lukmatuska/NeonPine/docs/compliance/04-eu-declaration-of-conformity.md

# EU Declaration of Conformity – DRAFT TEMPLATE

> **Do not sign until** the rev B hardware has passed EMC testing, the risk assessment is closed, and the RoHS evidence
> is complete. Fields in `[brackets]` are placeholders. Translate into the language(s) required by each member state of sale.

---

**EU DECLARATION OF CONFORMITY**  No. `[NP-DoC-001]`

1. **Product model / product:** NeonPine, decorative neon‑lamp Christmas tree, model `[NP‑1]`, hardware rev `[B]`,
   firmware `[x.y]`. Batch / serial range: `[from … to …]`.
2. **Name and address of the manufacturer** (and authorised representative, if any):
   `[Company name, street, postcode, city, country, e‑mail, web]`
   `[EU authorised representative / responsible economic operator under GPSR Art. 16: name, address]`
3. This declaration of conformity is issued under the sole responsibility of the manufacturer.
4. **Object of the declaration:** NeonPine model `[NP‑1]`, USB‑powered (5 V ⎓, ≤ 0.15 A) decorative light with ten neon glow
   lamps on a tree‑shaped printed circuit board. `[photo]`
5. The object of the declaration described above is in conformity with the relevant Union harmonisation legislation:
   * Directive **2014/30/EU** (electromagnetic compatibility)
   * Directive **2011/65/EU** and Commission Delegated Directive **(EU) 2015/863** (RoHS)
6. **References to the relevant harmonised standards used:**
   * EN IEC 55015:`[year+A]` *(or EN 55032:`[year]` Class B, according to the lab classification)*
   * EN 61547:`[year]` *(or EN 55035:`[year]`)*
   * EN IEC 63000:2018 (technical documentation for RoHS)
7. Notified body: **not applicable** (internal production control, Module A).
8. **Additional information:**
   * Product safety assessed under Regulation (EU) 2023/988 (GPSR) with reference to EN IEC 60598‑1, EN IEC 62368‑1
     (energy‑source method) and EN 62471. Risk assessment `[ref / rev]`.
   * Tested with power adapter `[make/model]` and a 1 m USB‑C cable.
   * WEEE producer registration numbers: `[DE: WEEE‑Reg.‑Nr. …, CZ: …, …]`

Signed for and on behalf of: `[Company]`
Place and date of issue: `[city, YYYY‑MM‑DD]`
Name, function: `[name, title]`  Signature: ____________________
