lukmatuska/NeonPine/docs/compliance/05-fcc-sdoc.md

# FCC Supplier's Declaration of Conformity – DRAFT

> 47 CFR §2.1077 compliance information. It must ship with the product (in the manual or as an insert) and the SDoC record
> must be kept by the **US‑based responsible party**. Fill in after the accredited lab report (Part 15 Subpart B, Class B) is issued.

## Compliance information statement (include in the user manual)

**Supplier's Declaration of Conformity**
47 CFR §2.1077 Compliance Information

**Unique identifier:** NeonPine, model `[NP‑1]`

**Responsible party – U.S. contact information:**
`[Company name]`
`[Street address, City, State ZIP, USA]`
`[Telephone number or internet contact]`

**FCC compliance statement (§15.19(a)(3)):**
This device complies with Part 15 of the FCC Rules. Operation is subject to the following two conditions:
(1) This device may not cause harmful interference, and (2) this device must accept any interference received, including
interference that may cause undesired operation.

**Information to the user (§15.105(b), Class B):**
NOTE: This equipment has been tested and found to comply with the limits for a Class B digital device, pursuant to Part 15
of the FCC Rules. These limits are designed to provide reasonable protection against harmful interference in a residential
installation. This equipment generates, uses and can radiate radio frequency energy and, if not installed and used in
accordance with the instructions, may cause harmful interference to radio communications. However, there is no guarantee
that interference will not occur in a particular installation. If this equipment does cause harmful interference to radio or
television reception, which can be determined by turning the equipment off and on, the user is encouraged to try to correct
the interference by one or more of the following measures:
* Reorient or relocate the receiving antenna.
* Increase the separation between the equipment and receiver.
* Connect the equipment into an outlet on a circuit different from that to which the receiver is connected.
* Consult the dealer or an experienced radio/TV technician for help.

**Modifications (§15.21):**
Changes or modifications not expressly approved by the party responsible for compliance could void the user's authority to
operate the equipment.

## Labelling (§15.19)
* The product is small, but the board has room for the short statement on the rear cover. If it doesn't fit legibly (≥ 4–6 pt),
  §15.19(a)(5) allows it to go in the user manual or on the packaging instead. **Recommended:** the full statement in the manual
  + packaging, plus model and responsible party name on the rear cover.
* The FCC logo is optional for SDoC devices.

## SDoC record to keep (not shipped)
* Lab test report (accredited lab), test setup photos, firmware version, adapter and cable used.
* Schematic, BOM, PCB rev and photos of the production unit.
* A statement that production units are identical to the tested sample, plus a change‑control note: re‑evaluate for any change to
  the boost converter, the MCU clock, the PCB layout or the USB connector.
