lukmatuska/NeonPine/docs/compliance/07-technical-file-index.md

# NeonPine – technical documentation (technical file) index

Keep for **10 years** after the last unit is placed on the EU market (EMC Directive Art. 7(3), GPSR Art. 9(2)). Must be
available to market surveillance authorities on request, in a language they understand.

| # | Document | Location | Status |
|---|---|---|---|
| 1 | General description, intended use, variants | `DESIGN.md` §1, `docs/user-manual.md` | draft |
| 2 | Schematic | `docs/NeonPine-schematic.pdf` | rev B |
| 3 | PCB layout, layer plots, 3D (main board + rear cover/stand) | `fab/gerber/`, `fab/cover/`, `docs/img/`, `fab/NeonPine.step` | rev B |
| 4 | Bill of materials with manufacturer part numbers | `fab/NeonPine-bom.csv` (+ MPN column: **to add**) | partial |
| 5 | Component datasheets (U1, Q1, L11, D1, D2, C4, NEON‑3, MMBTA42, J1, F1) | `docs/datasheets/` (**to collect**) | open |
| 6 | Risk assessment (GPSR) | `docs/compliance/01-risk-assessment.md` | rev 1 draft |
| 7 | EMC design review + test plan | `docs/compliance/02-emc-test-plan.md` | draft |
| 8 | EMC test reports (EU + FCC) | `docs/compliance/reports/` | open |
| 9 | Safety test record (§5 of the risk assessment) | `docs/compliance/reports/` | open |
| 10 | RoHS file: supplier declarations / material declarations per BOM line, EN IEC 63000 assessment | `docs/compliance/rohs/` | open |
| 11 | REACH SVHC statement, SCIP number (if needed) | `docs/compliance/rohs/` | open |
| 12 | Lamp supplier declaration: no radioactive additive | `docs/compliance/rohs/` | **open – blocking** |
| 13 | User manual + safety information (all languages) | `docs/user-manual.md` | EN draft |
| 14 | Labels and markings artwork | `docs/compliance/06-labelling-and-packaging.md` | draft |
| 15 | EU Declaration of Conformity (signed) | `docs/compliance/04-eu-declaration-of-conformity.md` | template |
| 16 | FCC SDoC record | `docs/compliance/05-fcc-sdoc.md` | template |
| 17 | Production control: test procedure, firmware version, traceability | `docs/manufacturing.md` | draft |
| 18 | Change log / design revisions | `DESIGN.md`, VCS history | — |
| 19 | Incident / complaint handling procedure (GPSR Art. 9(13), Safety Business Gateway) | `[QMS]` | open |
