lukmatuska/NeonPine/docs/README.pdf

# NeonPine documentation

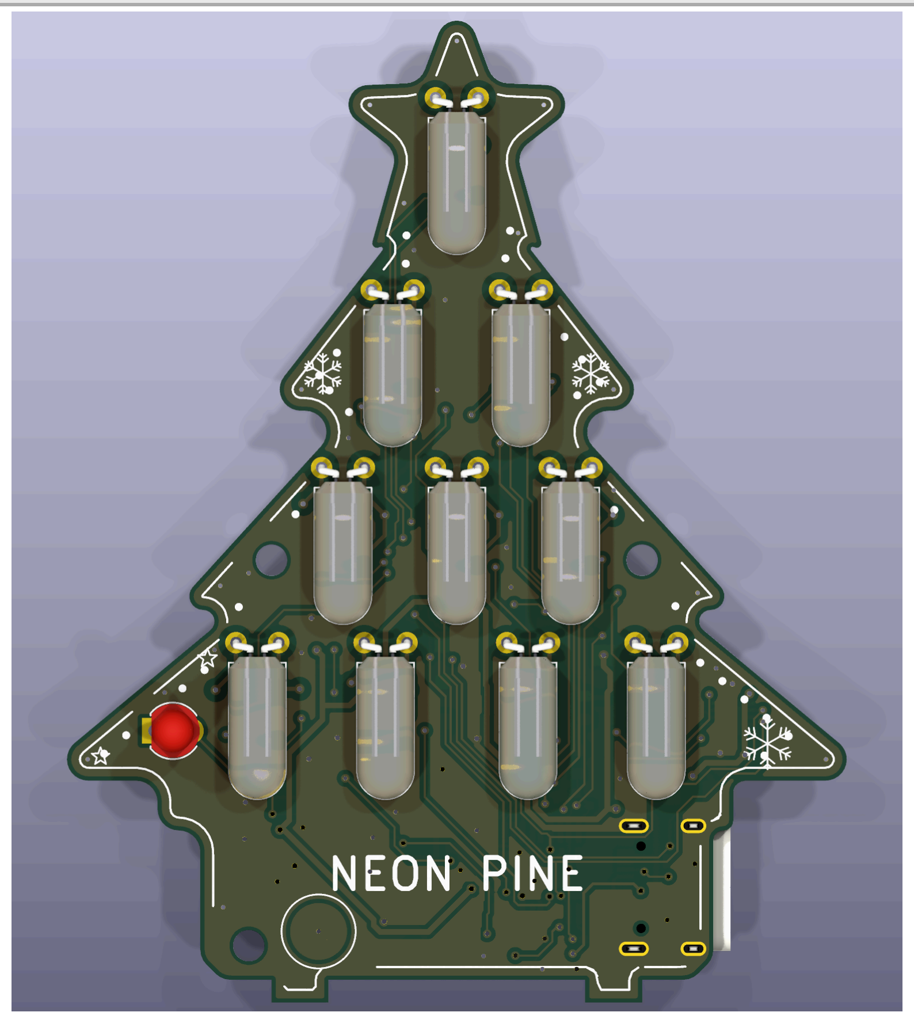
[picture p11: figure]
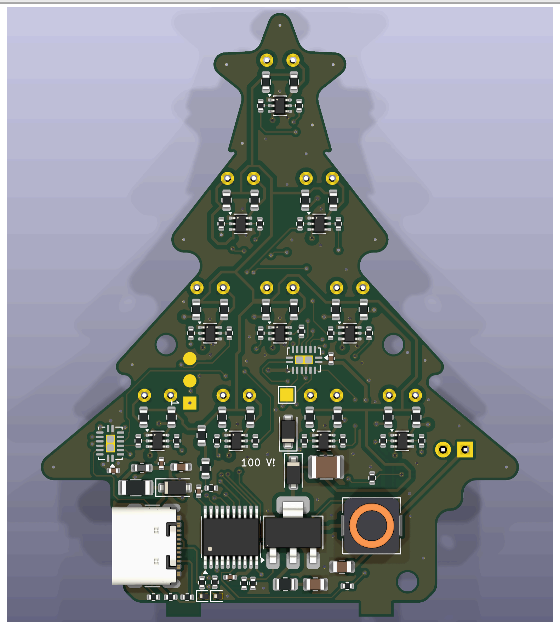
[picture p12: figure]

Document | Purpose
../DESIGN.md | Design description, schematic notes, layout, BOM, open items before market
NeonPine-schematic.pdf | Schematic
user-manual.md | User manual + safety information (EN draft)
manufacturing.md | PCB spec, assembly, programming, end‑of‑line test, traceability
mcu-netlist.md | Reduced netlist for firmware: U1 pin map, 74HC595 bit order, lamp drivers, peripheral / option-byte setup (generated by tools/mcu_netlist.py )
compliance/00-regulatory-roadmap.md | What applies (CE / UKCA / FCC / ICES), what doesn't, status tracker
compliance/01-risk-assessment.md | GPSR risk assessment, hazard register, verification record
compliance/02-emc-test-plan.md | EMC design review, rev B measures, pre‑compliance & lab test plan
compliance/03-materials-compliance.md | RoHS / REACH evidence per BOM line
compliance/04-eu-declaration-of-conformity.md | EU DoC template
compliance/05-fcc-sdoc.md | FCC SDoC + mandatory user statements
compliance/06-labelling-and-packaging.md | Product / packaging markings
compliance/07-technical-file-index.md | Technical file contents and status

python3 tools/docs.py regenerates the schematic PDF, the renders in img/ ( kicad-cli pcb render ), mcu-netlist.md , the fab/ outputs and all PDFs except the compliance documents; run it after every schematic or layout change.
