lukmatuska/NeonPine/bom/LCSC__WM2610200104_20261106025753.csv

LCSC Part Number | Manufacture Part Number | Manufacturer | Customer NO. | Package | Description | RoHS | Quantity | Unit Price($) | Ext.Price($) | Estimated lead time (business days) | Updated lead time | Date Code / Lot No.
C22435939 | CGA0402X7R104M160GT | HRE |  | 0402 | 100nF ±20% 16V Ceramic Capacitor X7R 0402 | YES | 100 | 0.0019 | 0.19
C25741 | 0402WGF1003TCE | UNI-ROYAL |  | 0402 | 100kΩ ±1% 62.5mW 0402 Thick Film Resistor | YES | 100 | 0.0015 | 0.15
C54920991 | HRC0603J105 ENTN | HWA CHN |  | 0603 | 100mW 1MΩ 50V Thick Film Resistor ±5% ±100ppm/℃ 0603 Chip Resistor - Surface Mount | YES | 100 | 0.0011 | 0.11
C730243 | 74HC595BQ,115 | Nexperia |  | DHVQFN-16-EP(2.5x3.5) | 2V~6V 35mA 19ns@4.5V,50pF Serial-to-Serial or Parallel DHVQFN-16-EP(2.5x3.5) Shift Registers RoHS | YES | 20 | 0.183 | 3.66
C5187096 | CH32V003F4P6 | WCH |  | TSSOP-20-175mil | RISC-V2A 32 Bit 48MHz TSSOP-20-175mil Microcontrollers | YES | 10 | 0.3129 | 3.13
C54920790 | HRC0402J393 DNTO | HWA CHN |  | 0402 | 62.5mW 39kΩ 50V Thick Film Resistor ±5% ±100ppm/℃ 0402 Chip Resistor - Surface Mount | YES | 100 | 0.0006 | 0.06
C54920757 | HRC0402J223 DNTO | HWA CHN |  | 0402 | 62.5mW 22kΩ 50V Thick Film Resistor ±5% ±100ppm/℃ 0402 Chip Resistor - Surface Mount | YES | 300 | 0.0006 | 0.18
C54920691 | HRC0402F5101DNTO | HWA CHN |  | 0402 | 62.5mW 5.1kΩ 50V Thick Film Resistor ±1% ±100ppm/℃ 0402 Chip Resistor - Surface Mount | YES | 100 | 0.0007 | 0.07
C2091910 | ESR03EZPJ154 | ROHM |  | 0603 | 250mW 150kΩ 150V Thick Film Resistor ±200ppm/℃ ±5% 0603 Chip Resistor - Surface Mount RoHS | YES | 200 | 0.0219 | 4.38
C54920744 | HRC0402J152 DNTO | HWA CHN |  | 0402 | 1.5kΩ 62.5mW 50V Thick Film Resistor ±5% ±100ppm/℃ 0402 Chip Resistor - Surface Mount | YES | 200 | 0.0006 | 0.12
C55098338 | HRC0402J680 DNTO | HWA CHN |  | 0402 | 62.5mW 68Ω 50V Thick Film Resistor ±200ppm/℃ ±5% 0402 Chip Resistor - Surface Mount | YES | 100 | 0.0006 | 0.06
C54921248 | HRC0805J101 FNTN | HWA CHN |  | 0805 | 100Ω 125mW 150V Thick Film Resistor ±5% ±100ppm/℃ 0805 Chip Resistor - Surface Mount | YES | 100 | 0.0017 | 0.17
C11702 | 0402WGF1001TCE | UNI-ROYAL |  | 0402 | 1kΩ ±1% 62.5mW 0402 Thick Film Resistor | YES | 100 | 0.0013 | 0.13
C55098334 | HRC0402J470 DNTO | HWA CHN |  | 0402 | 47Ω 62.5mW 50V Thick Film Resistor ±200ppm/℃ ±5% 0402 Chip Resistor - Surface Mount | YES | 100 | 0.0006 | 0.06
C894835 | FDT86246 | onsemi |  | SOT-223 | N-Channel 150V 2A 2.2W Surface Mount SOT-223 | YES | 10 | 1.0399 | 10.40
C53477423 | MMDT5551 | YTL |  | SOT-363 | 160V 250 600mA NPN 2 NPN SOT-363 Single Bipolar Transistors | YES | 100 | 0.0293 | 2.93
C6119842 | CGA0603X5R106K100JT | HRE |  | 0603 | 10uF ±10% 10V Ceramic Capacitor X5R 0603 | YES | 50 | 0.0174 | 0.87
C380336 | TCC0805X5R226K100FT | CCTC |  | 0805 | 22uF ±10% 10V Ceramic Capacitor X5R 0805 | YES | 10 | 0.0637 | 0.64
C840322 | NC1812B105K251CEMN | HUI JU |  | 1812 | 1uF ±10% 250V Ceramic Capacitor X7R 1812 | YES | 10 | 0.1543 | 1.54
C15195 | CL05B103KB5NNNC | Samsung Electro-Mechanics |  | 0402 | 10nF ±10% 50V Ceramic Capacitor X7R 0402 | YES | 100 | 0.0041 | 0.41
C48579314 | 0805C0G101J251NT | AIDE CAPACITOR |  | 0805 | 100pF ±5% 250V Ceramic Capacitor C0G 0805 | YES | 50 | 0.0056 | 0.28
C1976959 | SMF100A | Littelfuse |  | SOD-123FL | 162VC Clamp 1.1A Ipp TVS DIODE SOD-123FL | YES | 10 | 0.1613 | 1.61
C52148343 | SMF5.0A | YTL |  | SOD-123 | 9.2V 21.7A@10/1000us 200W@10/1000us 7.1V Unidirectional 5V SOD-123 TVS Diodes | YES | 50 | 0.0151 | 0.76
C41407569 | BZX884-C3V6 | TECH PUBLIC |  | DFN1006-2 | 1 Independent 34V~38V 36V DFN1006-2 Single Zener Diodes | YES | 20 | 0.0303 | 0.61
C54874038 | ASMD1206-050-13.2V | JDTfuse |  | 1206 | 13.2V 500mA 100A 1A 150mΩ 1206 PTC Resettable Fuses | YES | 10 | 0.0503 | 0.50
C309347 | USB-310-B-SU | HOOYA |  | SMD | USB-C (USB TYPE-C) Receptacle Connector Surface Mount, Right Angle | YES | 10 | 0.2248 | 2.25
C7588725 | CR5040-331M | Ceaiya |  | SMD,5x5mm | 400mA 330uH ±20% 2.1Ω 450mA SMD,5x5mm Fixed Inductors RoHS | YES | 10 | 0.0471 | 0.47
C22368821 | A4 | Wild Goose |  | SOD-123FL | Diode 400V 1A Surface Mount SOD-123FL | YES | 100 | 0.005 | 0.50
C1779 | CL21A475KAQNNNE | Samsung Electro-Mechanics |  | 0805 | 4.7uF ±10% 25V Ceramic Capacitor X5R 0805 | YES | 20 | 0.0387 | 0.77
C2718488 | 2.54-1*4P | BOOMELE(Boom Precision Elec) |  | Through Hole,P=2.54mm | Female Header 4 Position 2.54mm Pitch Single Row Through Hole -40℃~+105℃ | YES | 10 | 0.0832 | 0.83
C189893 | SM02B-GHS-TB(LF)(SN) | JST |  | SMD,P=1.25mm,Surface Mount,Right Angle | Connector Header 2 position 1.25mm Pitch 1A Surface Mount, Right Angle -25℃~+85℃ | YES | 10 | 0.5102 | 5.10
C42400234 | HYCW575-USBC06-680B | HOAUC |  | SMD | USB-C (USB TYPE-C) Receptacle Connector 6 Position Surface Mount, Right Angle | YES | 20 | 0.0238 | 0.48
C2297 | KT-0805G | Hubei KENTO Elec |  | 0805 | Emerald Green 525nm LED Indication - Discrete 2.6V~3.1V 0805 | YES | 50 | 0.0165 | 0.83
C557599 | TS665ZJ | SHOU HAN |  | Through Hole,Right Angle,6.2x6.2mm | Tactile Switch SPST 250gf 5mm PC Pin 6.2mm x 6.2mm Through Hole, Right Angle | YES | 20 | 0.0359 | 0.72
C8598 | B5819W SL | JSCJ |  | SOD-123 | Diode 40V 1A Surface Mount SOD-123 | YES | 20 | 0.0285 | 0.57
C84256 | NCD0805R1 | NATIONSTAR |  | 0805 | Red 630nm LED Indication - Discrete 1.6V~2.6V 0805 | YES | 50 | 0.0135 | 0.68
C18185759 | TCC0805X5R106M250FT | CCTC |  | 0805 | 10uF ±20% 25V Ceramic Capacitor X5R 0805 | YES | 10 | 0.0936 | 0.94
C49678 | CC0805KRX7R9BB104 | YAGEO |  | 0805 | 100nF ±10% 50V Ceramic Capacitor X7R 0805 | YES | 40 | 0.0206 | 0.82
C91185 | CC0805KKX7R9BB105 | YAGEO |  | 0805 | 1uF ±10% 50V Ceramic Capacitor X7R 0805 | YES | 20 | 0.0342 | 0.68
C15127 | AO3401A | AOS |  | SOT-23 | 30V 4A Surface Mount SOT-23 | YES | 10 | 0.103 | 1.03
C27834 | 0805W8F5101T5E | UNI-ROYAL |  | 0805 | 5.1kΩ ±1% 125mW 0805 Thick Film Resistor | YES | 100 | 0.0055 | 0.55
C2907264 | FRC0805F4701TS | FOJAN |  | 0805 | 4.7kΩ ±1% 125mW 0805 Thick Film Resistor | YES | 100 | 0.0031 | 0.31
C17513 | 0805W8F1001T5E | UNI-ROYAL |  | 0805 | 1kΩ ±1% 125mW 0805 Thick Film Resistor | YES | 100 | 0.0035 | 0.35
C17407 | 0805W8F1003T5E (SMT) | UNI-ROYAL |  | 0805 | 100kΩ ±1% 0805 Chip Resistor - Surface Mount | YES | 100 | 0.0028 | 0.28
C221530 | OS102011MA1QS1 | C&K |  | Through Hole | Slide Switch SPDT 100mA @ 12V Through Hole Rectangular Columnar | YES | 6 | 0.594 | 3.56
C45338508 | STM32C091KBT6 | ST |  | LQFP-32(7x7) | ARM Cortex-M0+ 32 Bit 48MHz LQFP-32(7x7) Microcontrollers RoHS | YES | 6 | 2.6869 | 16.12
C21713960 | TP4054 | GOODWORK |  | SOT-23-5 | Linear Charging IC Lithium-ion/Polymer SOT-23-5 | YES | 20 | 0.0261 | 0.52
C82942 | ME6211C33M5G-N | MICRONE |  | SOT-23-5 | 3.3V Positive Fixed SOT-23-5 Voltage Regulators - Linear, Low Drop Out (LDO) Regulators RoHS | YES | 10 | 0.0619 | 0.62
C2897371 | PM254-1-08-Z-8.5 | HCTL |  | Through Hole,P=2.54mm | Female Header 8 Position 2.54mm Pitch Single Row Through Hole -40℃~+105℃ | YES | 6 | 0.1545 | 0.93
C507118 | ATTINY1616-MNR | MICROCHIP |  | QFN-20-EP(3x3) | AVR 8 Bit 20MHz QFN-20-EP(3x3) Microcontrollers RoHS | YES | 5 | 1.0512 | 5.26
C5157566 | D2FC-F-7N(20M) | OMRON |  | Through Hole | 1mA 6V Pin Plunger SPST-NO 20,000,000 cycles Through Hole Limit Switches RoHS | YES | 4 | 0.4442 | 1.78
C280690 | SBK160808T-601Y-N | Chilisin |  | 0603 | 600Ω@100MHz 1 Line Ferrite Bead 0603 300mA 500mΩ | YES | 20 | 0.0062 | 0.12
