lukmatuska/NeonPine/production/bom.csv

Designator | Footprint | Quantity | Value | LCSC Part #
C1 | 0603 | 1 | 10u
C10, C2, C6, C9 | 0402 | 4 | 100n
C3 | 0805 | 1 | 22u 10V
C4 | 1210 | 1 | 1u 250V
C5 | 0402 | 1 | 10n
C8 | 0805 | 1 | 100p C0G 250V
D1 | D_SOD-123F | 1 | 200V 1A fast SOD-123F (verify P/N)
D2 | D_SOD-123F | 1 | SMF100A
D3 | D_SOD-123F | 1 | SMF5.0A (TVS)
D4, D5 | D_SOD-882 | 2 | BZX884-C3V6
F1 | 1206 | 1 | PTC 0.5A (MF-NSMF050-2)
FB1 | 0603 | 1 | 600R@100MHz
J1 | USB_C_Receptacle_GCT_USB4105-xx-A_16P_TopMnt_Horizontal | 1 | USB-C 16P (USB4105-GF-A)
J2 | Pogo_1x03_P2.54mm | 1 | SWD pogo pads
L11 | L_6.3x6.3_H3 | 1 | 330u (SWPA6028S331MT, Isat>=0.4A)
LA1, LA10, LA2, LA3, LA4, LA5, LA6, LA7, LA8, LA9 | Lamp_Neon_Brightmaster_NEON-3_D4x10_P3.0 | 10 | NEON-3
Q1 | SOT-223-3_TabPin2 | 1 | DMN15H310SE
Q11, Q12, Q13, Q14, Q15, Q16, Q17, Q18, Q19, Q20 | SOT-363_SC-70-6 | 10 | MMDT5551
Q2 | LED_D3.0mm | 1 | TEPT4400
R1 | 0402 | 1 | 47
R11 | 0402 | 1 | 1k
R12 | 0805 | 1 | 100 (snubber)
R13, R14 | 0402 | 2 | 68
R15 | 0402 | 1 | 1k5
R2 | 0402 | 1 | 100k
R21, R22, R23, R24, R25, R26, R27, R28, R29, R30, R31, R32, R33, R34, R35, R36, R37, R38, R39, R40 | 0603 | 20 | 150k 200V
R3, R4 | 0402 | 2 | 5k1
R41, R42, R43, R44, R45, R46, R47, R48, R49, R50, R51, R52, R53, R54, R55, R56, R57, R58, R59, R60, R9 | 0402 | 21 | 22k
R5, R6 | 0603 | 2 | 1M
R7 | 0402 | 1 | 39k
TP2 | TouchPad_D4.0mm_Masked | 1 | Touch trunk
TP3 | TestPoint_Pad_1.5x1.5mm | 1 | SR_CLK test
U1 | TSSOP-20_4.4x6.5mm_P0.65mm | 1 | CH32V003F4P6
U2, U3 | DHVQFN-16-1EP_2.5x3.5mm_P0.5mm_EP1x2mm_EPGND | 2 | 74HC595BQ
