lukmatuska/NeonPine/fab/NeonPine-bom.csv

Reference | Value | Footprint | QUANTITY | DNP
C1 | 10u | Capacitor_SMD:C_0603_1608Metric | 1
C2,C6,C7 | 100n | Capacitor_SMD:C_0603_1608Metric | 3
C3 | 22u 10V | Capacitor_SMD:C_0805_2012Metric | 1
C4 | 1u 250V | Capacitor_SMD:C_1210_3225Metric | 1
C5 | 10n | Capacitor_SMD:C_0603_1608Metric | 1
C8 | 100p C0G 250V | Capacitor_SMD:C_0805_2012Metric | 1 | DNP
D1 | ES1D | Diode_SMD:D_SMA | 1
D2 | SMAJ100A | Diode_SMD:D_SMA | 1
D3 | SMF5.0A (TVS) | Diode_SMD:D_SOD-123F | 1
F1 | PTC 0.5A (MF-NSMF050-2) | Fuse:Fuse_1206_3216Metric | 1
FB1 | 600R@100MHz | Inductor_SMD:L_0603_1608Metric | 1
J1 | USB-C 6P (USB4125-GF-A) | Connector_USB:USB_C_Receptacle_GCT_USB4125-xx-x_6P_TopMnt_Horizontal | 1
J2 | SWD pogo pads | NeonPine:Pogo_1x03_P2.54mm | 1
L11 | 330u (SWPA6028S331MT, Isat>=0.4A) | NeonPine:L_6.3x6.3_H3 | 1
LA1-LA10 | NEON-3 | NeonPine:Lamp_Neon_Brightmaster_NEON-3_D4x10_P3.0 | 10
Q1 | DMN15H310SE | Package_TO_SOT_SMD:SOT-223-3_TabPin2 | 1
Q2 | TEPT4400 | LED_THT:LED_D3.0mm | 1
Q11-Q20 | MMBTA42 | Package_TO_SOT_SMD:SOT-23 | 10
R1 | 47 | Resistor_SMD:R_0603_1608Metric | 1
R2 | 100k | Resistor_SMD:R_0603_1608Metric | 1
R3,R4 | 5k1 | Resistor_SMD:R_0603_1608Metric | 2
R5,R6 | 1M | Resistor_SMD:R_0603_1608Metric | 2
R7 | 39k | Resistor_SMD:R_0603_1608Metric | 1
R9,R41-R50 | 22k | Resistor_SMD:R_0603_1608Metric | 11
R11 | 1k | Resistor_SMD:R_0603_1608Metric | 1
R12 | 100 (snubber) | Resistor_SMD:R_0805_2012Metric | 1 | DNP
R21-R30 | 150k | Resistor_SMD:R_0805_2012Metric | 10
TP2 | Touch trunk | NeonPine:TouchPad_D4.0mm_Masked | 1
TP3 | BUZZ/spare | TestPoint:TestPoint_Pad_1.5x1.5mm | 1
U1 | CH32V003F4P6 | Package_SO:TSSOP-20_4.4x6.5mm_P0.65mm | 1
