lukmatuska/NeonPine/fab/NeonPine.step

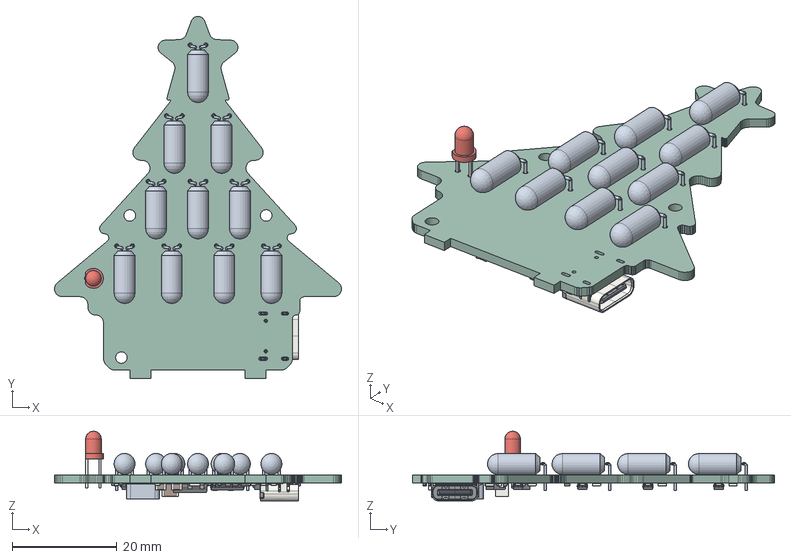
[picture p13: CAD file, 2026-10-14]
fab/NeonPine.step
54.7 x 69.0 x 13.3 mm
LED_D3.0mm
R_0402_1005Metric x 30
C_0805_2012Metric x 2
C_1210_3225Metric
SOT-363_SC-70-6 x 10
C_0402_1005Metric x 5
D_SOD-882 x 2
USB_C_Receptacle_16P_TopMnt_Horizontal_GCT_USB4105-xx-A
R_0603_1608Metric x 22
TSSOP-20_4.4x6.5mm_P0.65mm
C_0603_1608Metric
L_0603_1608Metric
D_SOD_123F x 3
R_0805_2012Metric
SOT-223
Fuse_1206_3216Metric
NeonPine_PCB
