lukmatuska/NeonPine/docs/user-manual.md

# NeonPine – user manual (English, DRAFT)

> Draft (H‑bridge + USB hardware; firmware not final). Items in `[brackets]` are placeholders. Translate into every language of the country of sale (GPSR Art. 9(7)).

NeonPine

## Read and keep these instructions

### ⚠ Safety information
* **Not a toy.** This is a decoration for adults. Not suitable for children under 3 years: it contains small parts and glass
  lamps. Keep it out of the reach of children and pets. Recommended for ages 14+.
* **Indoor use only.** Use in dry rooms only. Do not place it where it can get wet or covered in condensation (e.g. a cold
  windowsill), and do not clean it with liquids.
* **Power it only from a certified 5 V USB power adapter** (marked CE / UL‑listed, compliant with IEC 62368‑1) or a computer
  USB port. A power adapter is not included.
* **Do not remove the rear cover.** The product contains an internal circuit of up to about 110 V DC. There are no
  user‑serviceable parts inside.
* **Do not bend, pull or press the glass lamps.** If a lamp breaks: unplug the product, carefully collect the glass wearing gloves,
  and stop using the product.
* Place it on a stable, flat surface using the supplied stand. Keep it away from heat sources and open flames.
* Do not leave the USB cable where children can reach it, or where people can trip over it.
* Unplug it if it is damaged, makes unusual noises or smells, or does not work correctly.

## What's in the box
* NeonPine tree with screwed‑on rear cover · stand base · this manual
* *(Not included: USB‑C cable and 5 V USB power adapter)*

## Getting started
1. Push the two tabs at the bottom of the tree and of its rear cover into the four slots of the stand base (the side
   marked FRONT faces the lamps).
2. Connect a USB‑C cable to the socket on the right side of the "pot", and connect the other end to a 5 V USB power adapter.
3. The tree lights up. Neon lamps may take a few seconds to light the first time in a completely dark room. This is normal.

### Connecting to a computer
NeonPine can also be plugged into a computer's USB port. It then appears as a USB device (no driver needed on Windows).
With the **NeonPine Companion** app (Windows and Linux; it sits in the system tray) you can:
* switch animations, set the brightness, the sleep timer and the retro flicker,
* tune the built‑in animations (speed, brightness, base glow) and design your own: up to 8 custom animations are stored in
  the tree and play without the computer,
* let the tree react to music or to the computer's load,
* choose what the tree does when plugged in, which animations the trunk pad steps through, and give the tree a name,
* update the tree's firmware (your settings and animations are kept).

The tree keeps working normally while it is connected, and remembers your last animation, style and brightness.

## Controls
| Action | Result |
|---|---|
| Tap the **trunk pad** (round pad at the bottom left, below "NEON PINE") | Next light animation (crossfade) |
| Touch and hold the trunk pad | Adjust brightness (ramps up/down) |
| Double‑tap the trunk pad | Sleep timer on/off (dims over 20 min, then off) |
| Hold the trunk pad for 3 s | Off / on |
| Wave a hand over the tree | Next animation |
| Room gets dark / bright | Turns on at dusk, off in daylight; brightness follows the room (light sensor = the small ball in the left branch) |

Animations: Candle · Breathe · Twinkle · Garland · Snowfall · Heartbeat · Drift (changes automatically every 3 minutes) · Sleep.

## Specifications
| | |
|---|---|
| Model | NeonPine `[NP‑1]` |
| Input | 5 V ⎓ `[0.15]` A via USB‑C (USB 2.0 low‑speed data) |
| Light source | 10 neon glow lamps, orange (not replaceable) |
| Size | 55 × 69 mm (tree), base 50 × 26 mm, depth about 15 mm with the cover |
| Use | indoor, dry locations, 0–35 °C |

## Troubleshooting
| Problem | Solution |
|---|---|
| Nothing lights up | Check the cable and adapter. In daylight the tree switches off automatically; cover the tree with your hand to test |
| Some lamps light up late in the dark | Normal for neon lamps; they light within seconds |
| Lamps flicker on a computer USB port | Use a USB power adapter that can supply at least 0.5 A |
| The computer reports an unknown or unrecognised USB device | Unplug it and plug it in again, or use a power adapter if you do not need the computer connection `[firmware‑specific]` |

## Care
Wipe gently with a dry, soft cloth when the tree is unplugged. Do not use liquids or solvents.

## Disposal
`[crossed‑out wheeled bin symbol, EN 50419]`
This product must not be disposed of with household waste. Take it to a collection point for electrical and electronic
equipment. Retailers of electrical equipment are obliged to take it back free of charge `[country‑specific text]`.
Packaging: `[material codes / sorting info]`.

## Declarations
**EU:** `[Company]` declares that NeonPine `[NP‑1]` complies with Directive 2014/30/EU and Directive 2011/65/EU. The full text of the
EU declaration of conformity is available at `[https://…/doc/NP-1]`.

**USA – FCC:** see the compliance information statement in
[compliance/05-fcc-sdoc.md](compliance/05-fcc-sdoc.md). It must be printed here in the final manual: the §2.1077 statement,
§15.19, §15.105(b) and §15.21 texts.

**Manufacturer:** `[Company, address, e‑mail, web]` · **EU responsible person:** `[…]` · **UK importer:** `[…]`
