lukmatuska/NeonPine/docs/NeonPine-schematic.pdf

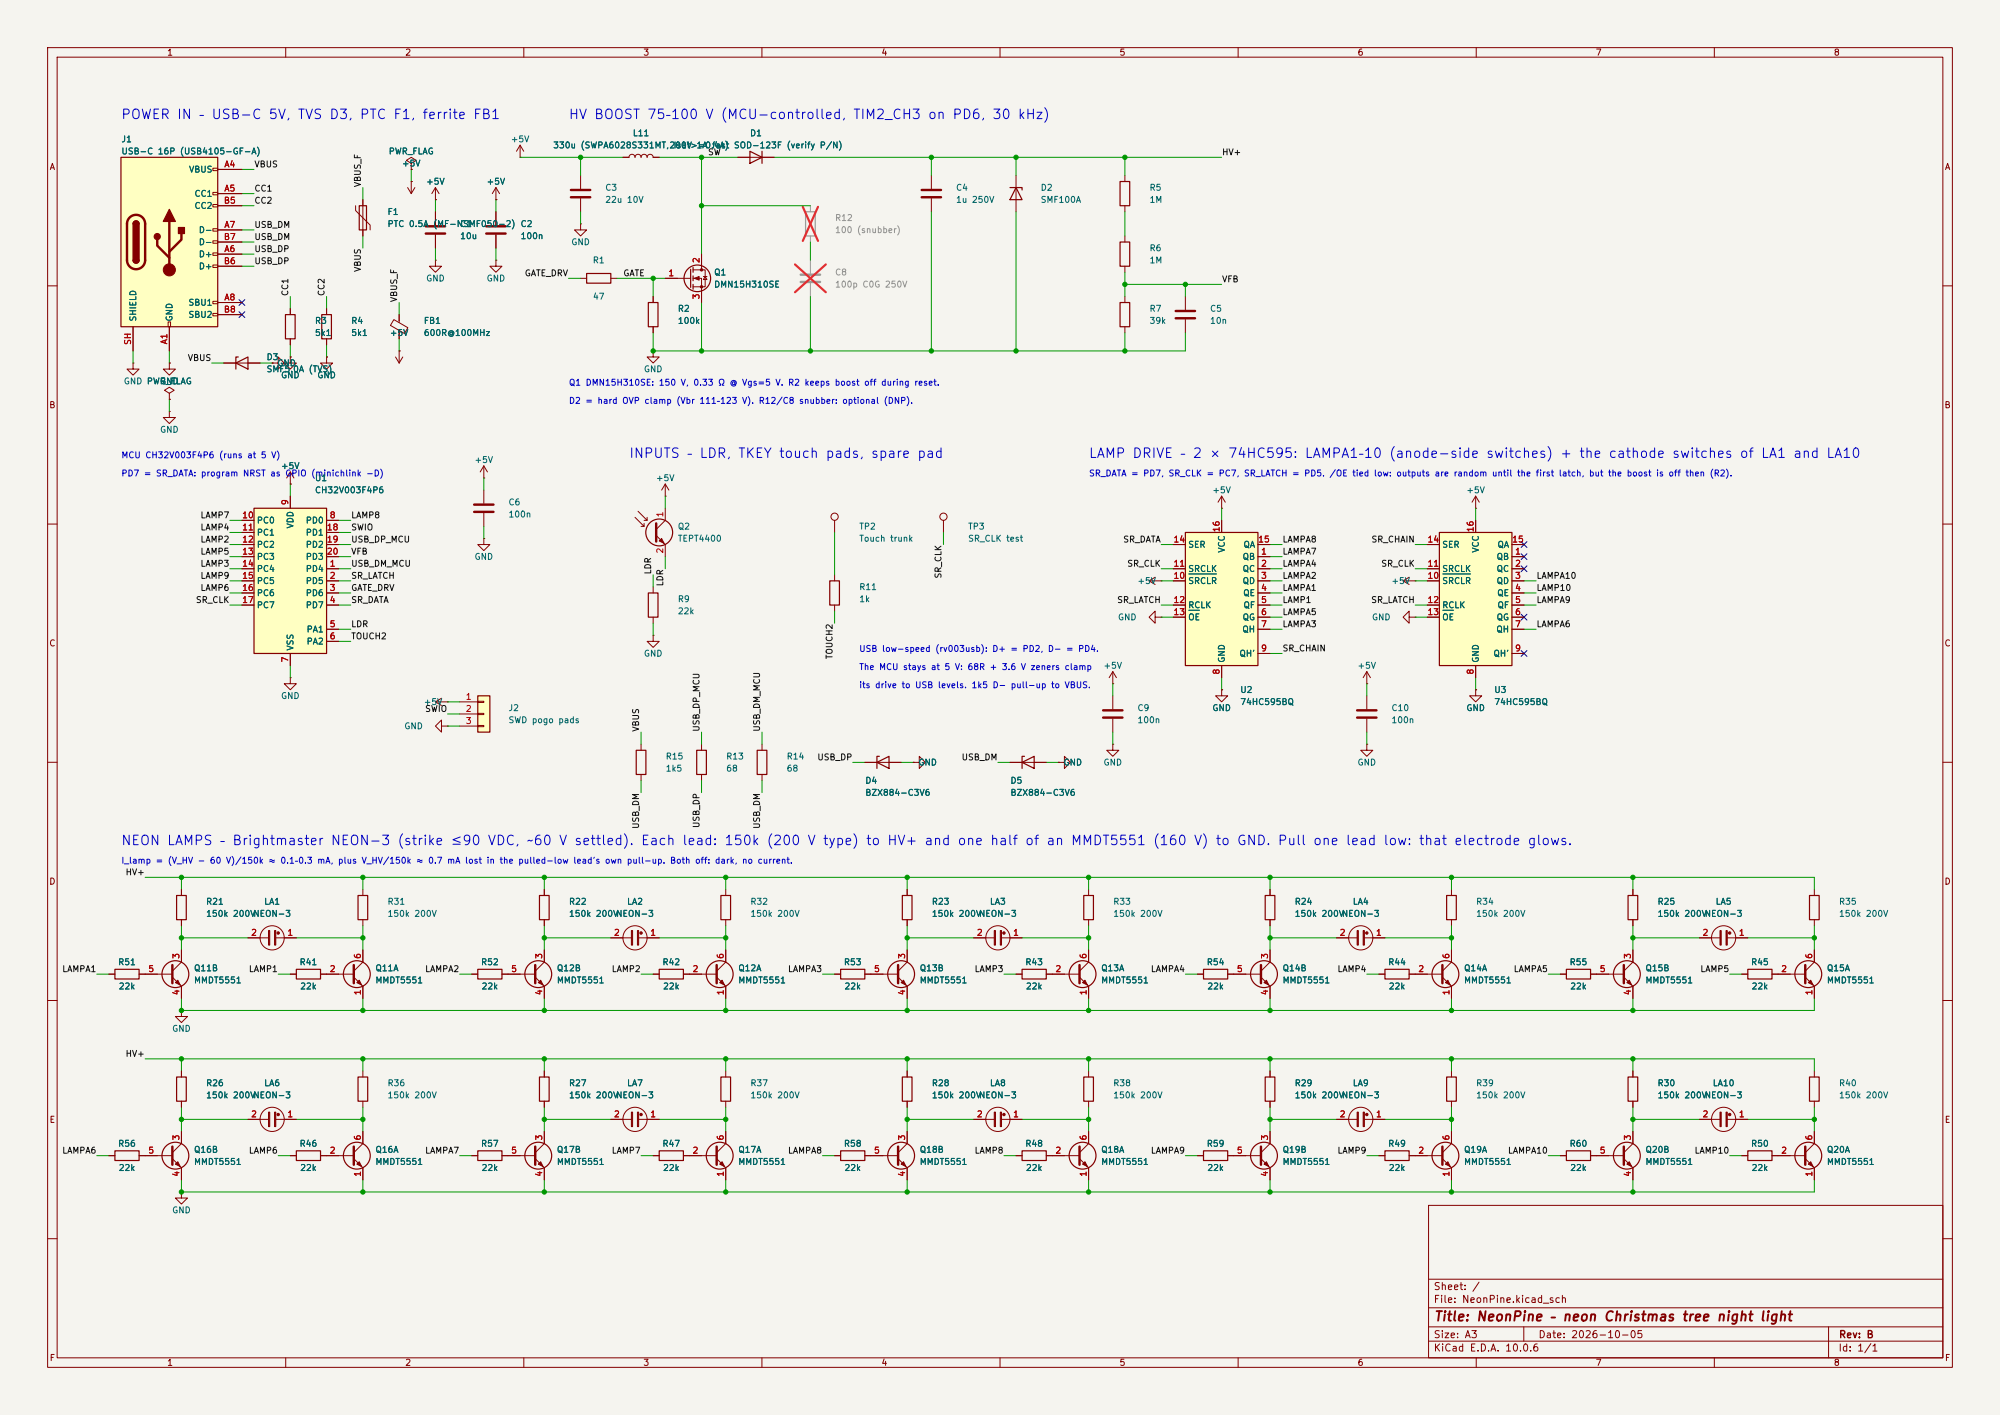
[picture p14: page 1]

POWER IN – USB-C 5V, TVS D3, PTC F1, ferrite FB1

HV BOOST 75–100 V (MCU-controlled, TIM2_CH3 on PD6, 30 kHz)

INPUTS – LDR, TKEY touch pads, spare pad

LAMP DRIVE – 2 × 74HC595: LAMPA1–10 (anode-side switches) + the cathode switches of LA1 and LA10

USB low-speed (rv003usb): D+ = PD2, D- = PD4. PD7 = SR_DATA: program NRST as GPIO (minichlink -D)

SRCLR 10 SRCLK 11 RCLK 12 OE 13

I_lamp = (V_HV - 60 V)/150k ≈ 0.1–0.3 mA, plus V_HV/150k ≈ 0.7 mA lost in the pulled-low lead's own pull-up. Both off: dark, no current.

Sheet: /
File: NeonPine.kicad_sch
Title: NeonPine – neon Christmas tree night light

Size: A3 | Rev: B | F Date: 2026-10-05
KiCad E.D.A. 10.0.6 | Id: 1/1
