lukmatuska/NeonPine/NeonPine.kicad_pcb

## KiCad design NeonPine.kicad_pcb (2026-10-14)

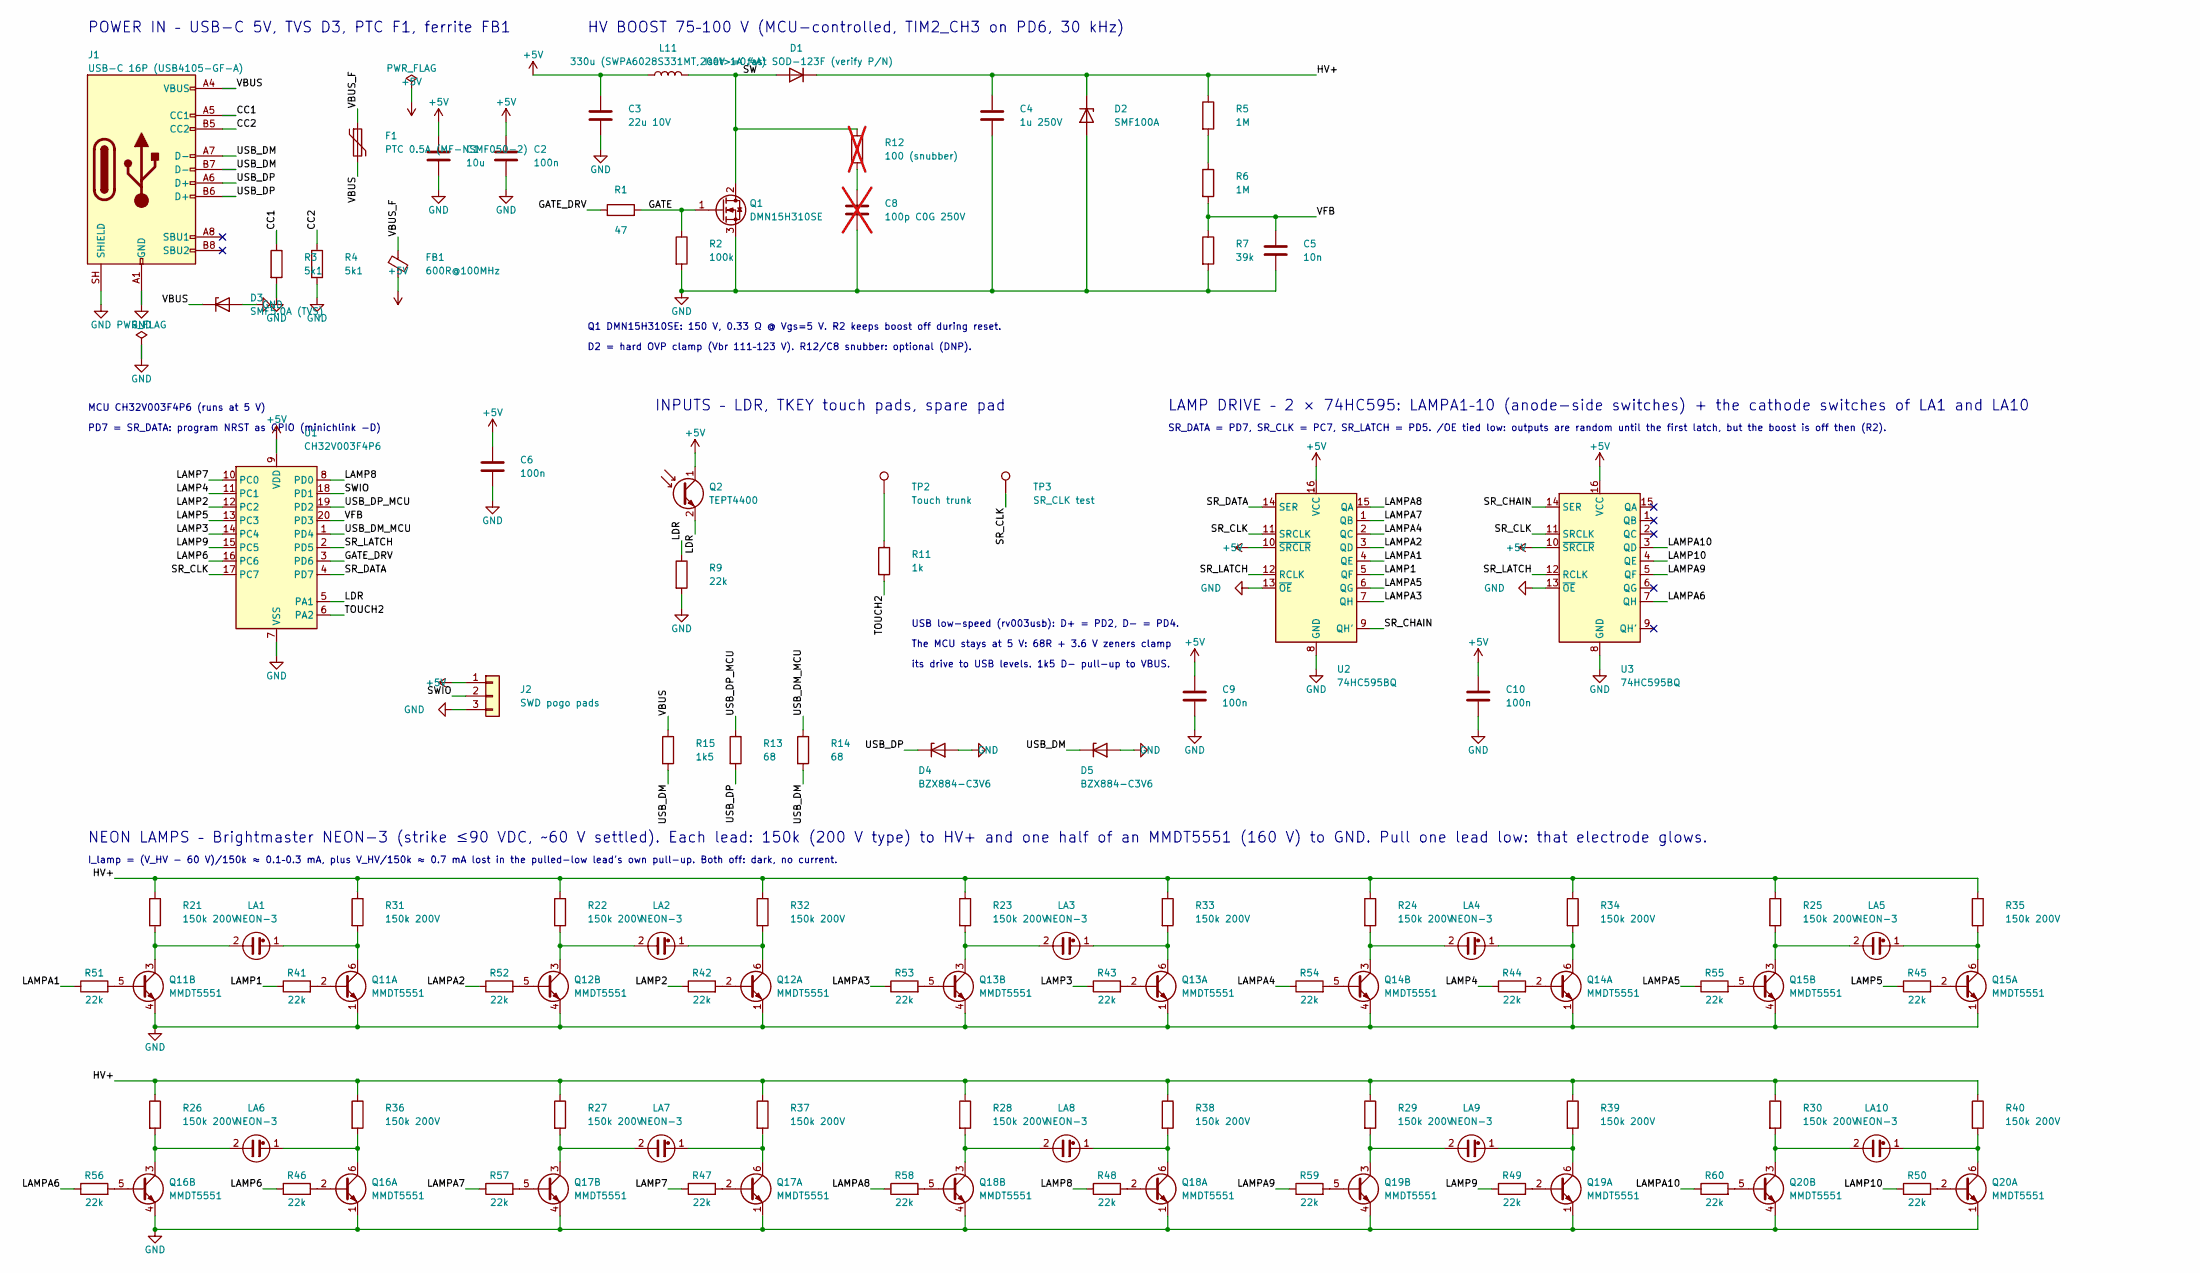
[picture p15: schematic NeonPine.kicad_sch, NeonPine – neon Christmas tree night light]

Parts:
C1: 10u; C_0603_1608Metric
C2, C6, C9, C10: 100n; C_0402_1005Metric
C3: 22u 10V; C_0805_2012Metric
C4: 1u 250V; C_1210_3225Metric
C5: 10n; C_0402_1005Metric
C8: 100p C0G 250V; C_0805_2012Metric; not fitted
D1: 200V 1A fast SOD-123F (verify P/N); D_SOD-123F
D2: SMF100A; D_SOD-123F
D3: SMF5.0A (TVS); D_SOD-123F
D4, D5: BZX884-C3V6; D_SOD-882
F1: PTC 0.5A (MF-NSMF050-2); Fuse_1206_3216Metric
FB1: 600R@100MHz; L_0603_1608Metric
J1: USB-C 16P (USB4105-GF-A); USB_C_Receptacle_GCT_USB4105-xx-A_16P_TopMnt_Horizontal
J2: SWD pogo pads; Pogo_1x03_P2.54mm
L11: 330u (SWPA6028S331MT, Isat>=0.4A); L_6.3x6.3_H3
LA1, LA2, LA3, LA4, LA5, LA6, LA7, LA8, LA9, LA10: NEON-3; Lamp_Neon_Brightmaster_NEON-3_D4x10_P3.0
Q1: DMN15H310SE; SOT-223-3_TabPin2
Q2: TEPT4400; LED_D3.0mm
Q11, Q12, Q13, Q14, Q15, Q16, Q17, Q18, Q19, Q20: MMDT5551; SOT-363_SC-70-6
R1: 47; R_0402_1005Metric
R2: 100k; R_0402_1005Metric
R3, R4: 5k1; R_0402_1005Metric
R5, R6: 1M; R_0603_1608Metric
R7: 39k; R_0402_1005Metric
R9, R41, R42, R43, R44, R45, R46, R47, R48, R49, R50, R51, R52, R53, R54, R55, R56, R57, R58, R59, R60: 22k; R_0402_1005Metric
R11: 1k; R_0402_1005Metric
R12: 100 (snubber); R_0805_2012Metric; not fitted
R13, R14: 68; R_0402_1005Metric
R15: 1k5; R_0402_1005Metric
R21, R22, R23, R24, R25, R26, R27, R28, R29, R30, R31, R32, R33, R34, R35, R36, R37, R38, R39, R40: 150k 200V; R_0603_1608Metric
TP2: Touch trunk; TouchPad_D4.0mm_Masked
TP3: SR_CLK test; TestPoint_Pad_1.5x1.5mm
U1: CH32V003F4P6; TSSOP-20_4.4x6.5mm_P0.65mm
U2, U3: 74HC595BQ; DHVQFN-16-1EP_2.5x3.5mm_P0.5mm_EP1x2mm_EPGND

Connections:
+5V: C1.1, C2.1, C3.1, C6.1, C9.1, C10.1, FB1.2, J2.1, L11.1, Q2.1 (C), U1.9 (VDD), U2.10 (~SRCLR), U2.16 (VCC), U3.10 (~SRCLR), U3.16 (VCC)
/CC1: J1.A5 (CC1), R3.1
/CC2: J1.B5 (CC2), R4.1
/GATE: Q1.1 (G), R1.2, R2.1
/GATE_DRV: R1.1, U1.3 (PD6)
/HV+: C4.1, D1.1 (K), D2.1 (K), R5.1, R21.1, R22.1, R23.1, R24.1, R25.1, R26.1, R27.1, R28.1, R29.1, R30.1, R31.1, R32.1, R33.1, R34.1, R35.1, R36.1, R37.1, R38.1, R39.1, R40.1
/LAMP1: R41.1, U2.5 (QF)
/LAMP2: R42.1, U1.12 (PC2)
/LAMP3: R43.1, U1.14 (PC4)
/LAMP4: R44.1, U1.11 (PC1)
/LAMP5: R45.1, U1.13 (PC3)
/LAMP6: R46.1, U1.16 (PC6)
/LAMP7: R47.1, U1.10 (PC0)
/LAMP8: R48.1, U1.8 (PD0)
/LAMP9: R49.1, U1.15 (PC5)
/LAMP10: R50.1, U3.4 (QE)
/LAMPA1: R51.1, U2.4 (QE)
/LAMPA2: R52.1, U2.3 (QD)
/LAMPA3: R53.1, U2.7 (QH)
/LAMPA4: R54.1, U2.2 (QC)
/LAMPA5: R55.1, U2.6 (QG)
/LAMPA6: R56.1, U3.7 (QH)
/LAMPA7: R57.1, U2.1 (QB)
/LAMPA8: R58.1, U2.15 (QA)
/LAMPA9: R59.1, U3.5 (QF)
/LAMPA10: R60.1, U3.3 (QD)
/LDR: Q2.2 (E), R9.1, U1.5 (PA1)
/SR_CHAIN: U2.9 (QH'), U3.14 (SER)
/SR_CLK: TP3.1 (1_1), U1.17 (PC7), U2.11 (SRCLK), U3.11 (SRCLK)
/SR_DATA: U1.4 (PD7), U2.14 (SER)
/SR_LATCH: U1.2 (PD5), U2.12 (RCLK), U3.12 (RCLK)
/SW: D1.2 (A), L11.2, Q1.2 (D), R12.1
/SWIO: J2.2, U1.18 (PD1)
/TOUCH2: R11.2, U1.6 (PA2)
/USB_DM: D5.1 (K), J1.A7 (D-), J1.B7 (D-), R14.2, R15.2
/USB_DM_MCU: R14.1, U1.1 (PD4)
/USB_DP: D4.1 (K), J1.A6 (D+), J1.B6 (D+), R13.2
/USB_DP_MCU: R13.1, U1.19 (PD2)
/VBUS: D3.1 (K), F1.2, J1.A4 (VBUS), J1.A9 (VBUS), J1.B4 (VBUS), J1.B9 (VBUS), R15.1
/VBUS_F: F1.1, FB1.1
/VFB: C5.1, R6.2, R7.1, U1.20 (PD3)
GND: C1.2, C2.2, C3.2, C4.2, C5.2, C6.2, C8.2, C9.2, C10.2, D2.2 (A), D3.2 (A), D4.2 (A), D5.2 (A), J1.A1 (GND), J1.A12 (GND), J1.B1 (GND), J1.B12 (GND), J1.SH (SHIELD), J2.3, Q1.3 (S), Q11.1 (E1), Q11.4 (E2), Q12.1 (E1), Q12.4 (E2), Q13.1 (E1), Q13.4 (E2), Q14.1 (E1), Q14.4 (E2), Q15.1 (E1), Q15.4 (E2), Q16.1 (E1), Q16.4 (E2), Q17.1 (E1), Q17.4 (E2), Q18.1 (E1), Q18.4 (E2), Q19.1 (E1), Q19.4 (E2), Q20.1 (E1), Q20.4 (E2), R2.2, R3.2, R4.2, R7.2, R9.2, U1.7 (VSS), U2.8 (GND), U2.13 (~OE), U3.8 (GND), U3.13 (~OE)
unnamed: C8.1, R12.2
unnamed: Q11.2 (B1), R41.2
unnamed: LA1.1, Q11.6 (C1), R31.2
unnamed: Q11.5 (B2), R51.2
unnamed: LA1.2, Q11.3 (C2), R21.2
unnamed: Q12.2 (B1), R42.2
unnamed: LA2.1, Q12.6 (C1), R32.2
unnamed: Q12.5 (B2), R52.2
unnamed: LA2.2, Q12.3 (C2), R22.2
unnamed: Q13.2 (B1), R43.2
unnamed: LA3.1, Q13.6 (C1), R33.2
unnamed: Q13.5 (B2), R53.2
unnamed: LA3.2, Q13.3 (C2), R23.2
unnamed: Q14.2 (B1), R44.2
unnamed: LA4.1, Q14.6 (C1), R34.2
unnamed: Q14.5 (B2), R54.2
unnamed: LA4.2, Q14.3 (C2), R24.2
unnamed: Q15.2 (B1), R45.2
unnamed: LA5.1, Q15.6 (C1), R35.2
unnamed: Q15.5 (B2), R55.2
unnamed: LA5.2, Q15.3 (C2), R25.2
unnamed: Q16.2 (B1), R46.2
unnamed: LA6.1, Q16.6 (C1), R36.2
unnamed: Q16.5 (B2), R56.2
unnamed: LA6.2, Q16.3 (C2), R26.2
unnamed: Q17.2 (B1), R47.2
unnamed: LA7.1, Q17.6 (C1), R37.2
unnamed: Q17.5 (B2), R57.2
unnamed: LA7.2, Q17.3 (C2), R27.2
unnamed: Q18.2 (B1), R48.2
unnamed: LA8.1, Q18.6 (C1), R38.2
unnamed: Q18.5 (B2), R58.2
unnamed: LA8.2, Q18.3 (C2), R28.2
unnamed: Q19.2 (B1), R49.2
unnamed: LA9.1, Q19.6 (C1), R39.2
unnamed: Q19.5 (B2), R59.2
unnamed: LA9.2, Q19.3 (C2), R29.2
unnamed: Q20.2 (B1), R50.2
unnamed: LA10.1, Q20.6 (C1), R40.2
unnamed: Q20.5 (B2), R60.2
unnamed: LA10.2, Q20.3 (C2), R30.2
unnamed: R5.2, R6.1
unnamed: R11.1, TP2.1 (1_1)

Notes on the sheet:
HV BOOST 75–100 V (MCU-controlled, TIM2_CH3 on PD6, 30 kHz)
D2 = hard OVP clamp (Vbr 111–123 V). R12/C8 snubber: optional (DNP).
LAMP DRIVE – 2 × 74HC595: LAMPA1–10 (anode-side switches) + the cathode switches of LA1 and LA10
INPUTS – LDR, TKEY touch pads, spare pad
POWER IN – USB-C 5V, TVS D3, PTC F1, ferrite FB1
I_lamp = (V_HV - 60 V)/150k ≈ 0.1–0.3 mA, plus V_HV/150k ≈ 0.7 mA lost in the pulled-low lead's own pull-up. Both off: dark, no current.
PD7 = SR_DATA: program NRST as GPIO (minichlink -D)
NEON LAMPS – Brightmaster NEON-3 (strike ≤90 VDC, ~60 V settled). Each lead: 150k (200 V type) to HV+ and one half of an MMDT5551 (160 V) to GND. Pull one lead low: that electrode glows.
Q1 DMN15H310SE: 150 V, 0.33 Ω @ Vgs=5 V. R2 keeps boost off during reset.
SR_DATA = PD7, SR_CLK = PC7, SR_LATCH = PD5. /OE tied low: outputs are random until the first latch, but the boost is off then (R2).
USB low-speed (rv003usb): D+ = PD2, D- = PD4.
its drive to USB levels. 1k5 D- pull-up to VBUS.
The MCU stays at 5 V: 68R + 3.6 V zeners clamp
MCU CH32V003F4P6 (runs at 5 V)

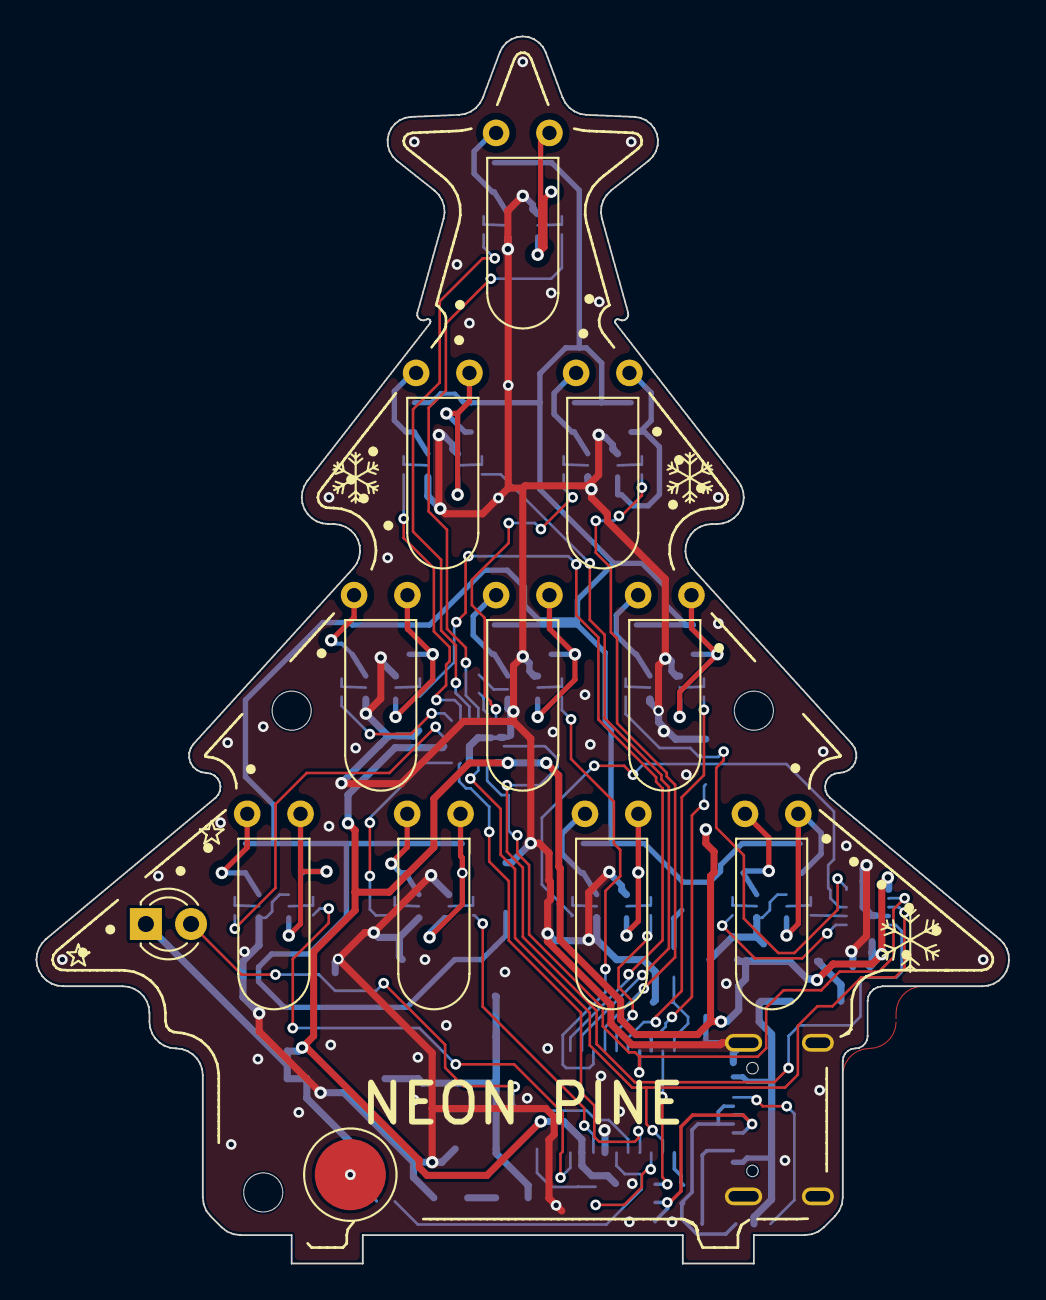
[picture p16: board NeonPine.kicad_pcb from above]

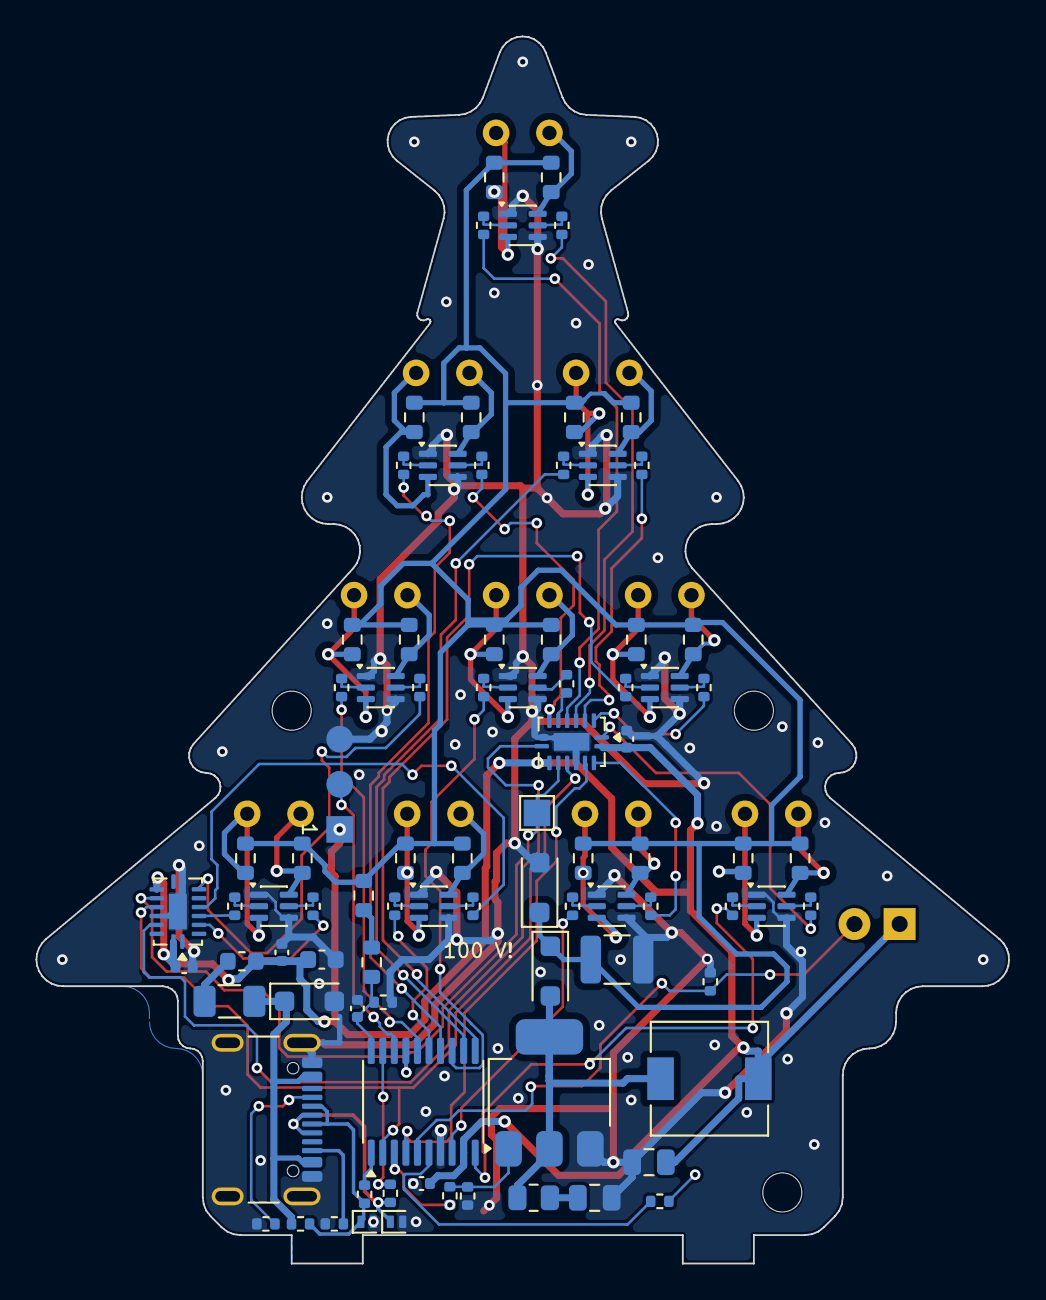
[picture p17: board NeonPine.kicad_pcb from below]

Board: 2 copper layers, 54.7 x 69.0 mm, 102 parts (87 on the bottom side), 85 nets.

Other parts of the board:
H1, H2, H3: M2 cover standoff; MountingHole_2.2mm_M2
