lukmatuska/NeonPine/tools/gen.py

import uuid, os, copy
from sx import *
_c=[0]
def U():
    _c[0]+=1; return str(uuid.uuid5(uuid.NAMESPACE_URL,'neonpine/%d'%_c[0]))
ROOT='f460b743-0f84-4eb6-8cd0-caf2149a2015'
FPDIR='/usr/share/kicad/footprints/'
PRJ=os.path.join(os.path.dirname(os.path.abspath(__file__)),'..')
R06='Resistor_SMD:R_0603_1608Metric'; R12='Resistor_SMD:R_1206_3216Metric'
C06='Capacitor_SMD:C_0603_1608Metric'
ZD='Diode_SMD:D_SOD-882'
R04='Resistor_SMD:R_0402_1005Metric'; C04='Capacitor_SMD:C_0402_1005Metric'   # low-voltage passives (0402: 50 V max)
parts=[]  # (ref,lib,name,x,y,value,fp,{pin:net},dnp,unit)
def P(ref,lib,name,x,y,val,fp,nets,dnp=False,unit=1): parts.append((ref,lib,name,x,y,val,fp,nets,dnp,unit))
# --- power in
# USB 2.0 receptacle (D+/D- wired for rv003usb low-speed USB); same GCT family / shell pattern as the old power-only USB4125
P('J1','Connector','USB_C_Receptacle_USB2.0_16P',35.56,50.8,'USB-C 16P (USB4105-GF-A)','Connector_USB:USB_C_Receptacle_GCT_USB4105-xx-A_16P_TopMnt_Horizontal',
  {'A4':'VBUS','A9':'VBUS','B4':'VBUS','B9':'VBUS','A5':'CC1','B5':'CC2','A6':'USB_DP','B6':'USB_DP','A7':'USB_DM','B7':'USB_DM',
   'A1':'GND','A12':'GND','B1':'GND','B12':'GND','SH':'GND'})
P('R3','Device','R',60.96,68.58,'5k1',R04,{'1':'CC1','2':'GND'})
P('R4','Device','R',68.58,68.58,'5k1',R04,{'1':'CC2','2':'GND'})
P('F1','Device','Polyfuse',76.2,45.72,'PTC 0.5A (MF-NSMF050-2)','Fuse:Fuse_1206_3216Metric',{'1':'VBUS_F','2':'VBUS'})
P('FB1','Device','FerriteBead_Small',83.82,68.58,'600R@100MHz','Inductor_SMD:L_0603_1608Metric',{'1':'VBUS_F','2':'+5V'})
P('D3','Device','D_Zener',50.8,76.2,'SMF5.0A (TVS)','Diode_SMD:D_SOD-123F',{'1':'VBUS','2':'GND'})
P('C1','Device','C',91.44,48.26,'10u',C06,{'1':'+5V','2':'GND'})
P('C2','Device','C',104.14,48.26,'100n',C04,{'1':'+5V','2':'GND'})
P('#FLG01','power','PWR_FLAG',86.36,35.56,'PWR_FLAG','',{'1':'+5V'})
P('#FLG02','power','PWR_FLAG',35.56,83.82,'PWR_FLAG','',{'1':'GND'})
# --- boost
P('C3','Device','C',121.92,48.26,'22u 10V','Capacitor_SMD:C_0805_2012Metric',{'1':'+5V','2':'GND'})
P('L11','Device','L',134.62,40.64,'330u (SWPA6028S331MT, Isat>=0.4A)','NeonPine:L_6.3x6.3_H3',{'1':'+5V','2':'SW'})
P('D1','Device','D',152.4,33.02,'200V 1A fast SOD-123F (verify P/N)','Diode_SMD:D_SOD-123F',{'2':'SW','1':'HV+'})
P('Q1','Transistor_FET','Q_NMOS_GDS',144.78,58.42,'DMN15H310SE','Package_TO_SOT_SMD:SOT-223-3_TabPin2',{'1':'GATE','2':'SW','3':'GND'})
P('R1','Device','R',129.54,68.58,'47',R04,{'1':'GATE_DRV','2':'GATE'})
P('R2','Device','R',137.16,68.58,'100k',R04,{'1':'GATE','2':'GND'})
P('C4','Device','C',170.18,48.26,'1u 250V','Capacitor_SMD:C_1210_3225Metric',{'1':'HV+','2':'GND'})
P('D2','Device','D_Zener',185.42,48.26,'SMF100A','Diode_SMD:D_SOD-123F',{'1':'HV+','2':'GND'})
P('R12','Device','R',228.6,40.64,'100 (snubber)','Resistor_SMD:R_0805_2012Metric',{'1':'SW','2':'SNUB'},dnp=True)
P('C8','Device','C',228.6,53.34,'100p C0G 250V','Capacitor_SMD:C_0805_2012Metric',{'1':'SNUB','2':'GND'},dnp=True)
P('R5','Device','R',208.28,40.64,'1M',R06,{'1':'HV+','2':'FB_MID'})
P('R6','Device','R',208.28,53.34,'1M',R06,{'1':'FB_MID','2':'VFB'})
P('R7','Device','R',208.28,66.04,'39k',R04,{'1':'VFB','2':'GND'})
P('C5','Device','C',218.44,66.04,'10n',C04,{'1':'VFB','2':'GND'})
# --- MCU. Lamp -> pin map (PC0-7 = pins 10-17, PD0 = 8, PD4 = 1) comes from tools/pinswap.py when present
_lp=os.path.join(os.path.dirname(os.path.abspath(__file__)),'lamp_pins.json')
import json
_j=json.load(open(_lp)) if os.path.exists(_lp) else {}
SR_SLOTS=_j.get('sr')                       # AC branch format: {"mcu": {pin: LAMPn}, "sr": [16 shift-register slots]}
LAMP_PINS=_j['mcu'] if 'mcu' in _j else _j if _j else {'10':'LAMP1','11':'LAMP2','12':'LAMP3','13':'LAMP4','14':'LAMP5',
  '15':'LAMP6','16':'LAMP7','17':'LAMP8','8':'LAMP9','1':'LAMP10'}
# --- MCU. USB (rv003usb): D+ = PD2, D- = PD4 (USB_PIN_DP/DM must be GPIO 0-4 of one port). That moves the boost gate from
# PD2 (TIM1_CH1) to PD6 (TIM2_CH3, TIM2 full remap), the light sensor to PA1 (A1), SR_LATCH to PD5, SR_CLK to PC7 and
# SR_DATA to PD7 - NRST must be configured as GPIO (minichlink -D). LAMP10's cathode switch moved to U3 (frees PC7).
LAMP_PINS={k:v for k,v in LAMP_PINS.items() if k in ('8','10','11','12','13','14','15','16')}
P('U1','MCU_WCH_RiscV','CH32V003FxPx',60.96,121.92,'CH32V003F4P6','Package_SO:TSSOP-20_4.4x6.5mm_P0.65mm',
  {**LAMP_PINS, '18':'SWIO','19':'USB_DP_MCU','20':'VFB','1':'USB_DM_MCU','2':'SR_LATCH','3':'GATE_DRV','4':'SR_DATA',
   '5':'LDR','6':'TOUCH2','17':'SR_CLK','9':'+5V','7':'GND'})
P('C6','Device','C',101.6,106.68,'100n',C04,{'1':'+5V','2':'GND'})
P('J2','Connector_Generic','Conn_01x03',101.6,149.86,'SWD pogo pads','NeonPine:Pogo_1x03_P2.54mm',
  {'1':'+5V','2':'SWIO','3':'GND'})
# --- inputs
P('Q2','Device','Q_Photo_NPN',137.16,111.76,'TEPT4400','LED_THT:LED_D3.0mm',{'1':'+5V','2':'LDR'})
P('R9','Device','R',137.16,127,'22k',R04,{'1':'LDR','2':'GND'})
P('TP2','Connector','TestPoint',175.26,111.76,'Touch trunk','NeonPine:TouchPad_D4.0mm_Masked',{'1':'TP_TRUNK'})
P('R11','Device','R',175.26,124.46,'1k',R04,{'1':'TP_TRUNK','2':'TOUCH2'})
P('TP3','Connector','TestPoint',198.12,111.76,'SR_CLK test','TestPoint:TestPoint_Pad_1.5x1.5mm',{'1':'SR_CLK'})
# --- lamps (x 10): each lead has a 150k pull-up to HV+ and one half of an MMDT5551 (dual 160 V NPN, SOT-363) to GND
# (an H-bridge per lamp: unit 1 = K side, unit 2 = A side). The pull-ups see up to 105 V (123 V at the D2 clamp), so they
# are 0603 high-voltage types (>= 200 V working voltage, e.g. RCV0603); ordinary 0603 thick film is only rated 75 V.
# Pulling one lead low makes that lead the cathode, so that electrode glows; both off = dark (see DESIGN.md 2.3).
# Drawn with explicit wires (MANUAL parts skip the automatic label stubs).
MANUAL=set(); ROT={}; PROPS={}; mw=[]; mj=[]; ml=[]; mp=[]   # manual wires, junctions, labels, power symbols
SR_LAMPS=[f'LAMPA{n}' for n in range(1,11)]+[f'LAMP{n}' for n in range(1,11) if f'LAMP{n}' not in LAMP_PINS.values()]
assert len(SR_LAMPS)<=16
COL0, PITCH, XK, ROW0, ROWP = 38.1, 76.2, 38.1, 184.15, 38.1
SOT363='Package_TO_SOT_SMD:SOT-363_SC-70-6'
for n in range(1,11):
    r,c=(n-1)//5,(n-1)%5
    xa=COL0+c*PITCH; xk=xa+XK; mid=xa+XK/2; Yr=ROW0+r*ROWP; yN=Yr+12.7; Yg=yN+15.24
    def M(ref,*a,rot=0,props=None,unit=1):
        P(ref,*a,unit=unit); MANUAL.add(ref); ROT[ref]=rot
        if props: PROPS[ref]=props
    M(f'R{20+n}','Device','R',xa,yN-6.35,'150k 200V',R06,{'1':'HV+','2':f'A{n}'})
    M(f'R{30+n}','Device','R',xk,yN-6.35,'150k 200V',R06,{'1':'HV+','2':f'K{n}'})
    M(f'LA{n}','Device','Lamp_Neon',mid,yN,'NEON-3','NeonPine:Lamp_Neon_Brightmaster_NEON-3_D4x10_P3.0',{'2':f'A{n}','1':f'K{n}'},
      rot=90,props=(mid,yN-7.62,mid,yN-5.08,None,90))
    M(f'Q{10+n}','Transistor_BJT','Q_Dual_NPN_NPN_E1B1C2E2B2C1',xa-2.54,yN+7.62,'MMDT5551',SOT363,{'3':f'A{n}','4':'GND','5':f'BA{n}'},unit=2)
    M(f'Q{10+n}','Transistor_BJT','Q_Dual_NPN_NPN_E1B1C2E2B2C1',xk-2.54,yN+7.62,'MMDT5551',SOT363,{'6':f'K{n}','1':'GND','2':f'B{n}'},unit=1)
    M(f'R{50+n}','Device','R',xa-11.43,yN+7.62,'22k',R04,{'1':f'LAMPA{n}','2':f'BA{n}'},rot=90,props=(xa-11.43,yN+5.08,xa-11.43,yN+10.16,None,90))
    M(f'R{40+n}','Device','R',xk-11.43,yN+7.62,'22k',R04,{'1':f'LAMP{n}','2':f'B{n}'},rot=90,props=(xk-11.43,yN+5.08,xk-11.43,yN+10.16,None,90))
    for x in (xa,xk):
        mw.append(((x,Yr),(x,yN-10.16))); mw.append(((x,yN-2.54),(x,yN))); mw.append(((x,yN),(x,yN+2.54)))
        mw.append(((x,yN+12.7),(x,Yg))); mj.append((x,yN))
    mw.append(((xa,yN),(mid-5.08,yN))); mw.append(((mid+5.08,yN),(xk,yN)))
    for x,net in ((xa,f'LAMPA{n}'),(xk,f'LAMP{n}')):
        mw.append(((x-15.24,yN+7.62),(x-17.78,yN+7.62))); ml.append((net,x-17.78,yN+7.62,180))
    if c==0:   # row rails: HV+ along the top, GND along the bottom
        x_end=COL0+4*PITCH+XK
        mw.append(((xa-7.62,Yr),(x_end,Yr))); ml.append(('HV+',xa-7.62,Yr,180))
        mw.append(((xa,Yg),(x_end,Yg))); mp.append(('GND',xa,Yg))
    for x in (xa,xk):
        if not (c==4 and x==xk): mj.append((x,Yr))
        if not (c==4 and x==xk): mj.append((x,Yg))
# --- lamp drive shift registers: 2 x 74HC595, outputs in SR_LAMPS order (firmware maps lamp -> bit by table)
SR_OUT=['15','1','2','3','4','5','6','7']   # QA..QH
if SR_SLOTS: assert sorted(x for x in SR_SLOTS if x)==sorted(SR_LAMPS), 'lamp_pins.json does not match'
srn=(lambda k:{SR_OUT[i]:SR_SLOTS[k*8+i] for i in range(8) if SR_SLOTS[k*8+i]}) if SR_SLOTS else \
    (lambda k:{SR_OUT[i]:SR_LAMPS[k*8+i] for i in range(8) if k*8+i<len(SR_LAMPS)})
PROPS['J1']=(25.4,29.21,25.4,31.75,'left',0)
PROPS['D4']=(181.61,163.83,181.61,166.37,'left',0); PROPS['D5']=(212.09,163.83,212.09,166.37,'left',0)
PROPS['U2']=(260.35,144.78,260.35,147.32,'left',0); PROPS['U3']=(313.69,144.78,313.69,147.32,'left',0)
P('U2','74xx','74HC595',256.54,124.46,'74HC595BQ','NeonPine:DHVQFN-16-1EP_2.5x3.5mm_P0.5mm_EP1x2mm_EPGND',
  {**srn(0),'14':'SR_DATA','11':'SR_CLK','12':'SR_LATCH','10':'+5V','13':'GND','9':'SR_CHAIN','16':'+5V','8':'GND'})
P('U3','74xx','74HC595',309.88,124.46,'74HC595BQ','NeonPine:DHVQFN-16-1EP_2.5x3.5mm_P0.5mm_EP1x2mm_EPGND',
  {**srn(1),'14':'SR_CHAIN','11':'SR_CLK','12':'SR_LATCH','10':'+5V','13':'GND','16':'+5V','8':'GND'})
P('C9','Device','C',233.68,149.86,'100n',C04,{'1':'+5V','2':'GND'})
P('C10','Device','C',287.02,149.86,'100n',C04,{'1':'+5V','2':'GND'})
# --- USB low-speed (rv003usb). The MCU stays at 5 V (full gate drive for Q1, no level shifter, no LDO): its 2.06 V V_IH at
# VDD = 5 V reads the 3.3 V bus directly, and on transmit the 68R series resistors + 3.6 V zeners clamp its 5 V push-pull
# drive to the USB level. D- pull-up (low-speed device) 1k5 to VBUS, also clamped by D5; device is always on-bus.
P('R13','Device','R',147.32,160.02,'68',R04,{'1':'USB_DP_MCU','2':'USB_DP'})
P('R14','Device','R',160.02,160.02,'68',R04,{'1':'USB_DM_MCU','2':'USB_DM'})
P('D4','Device','D_Zener',185.42,160.02,'BZX884-C3V6',ZD,{'1':'USB_DP','2':'GND'})
P('D5','Device','D_Zener',215.9,160.02,'BZX884-C3V6',ZD,{'1':'USB_DM','2':'GND'})
P('R15','Device','R',134.62,160.02,'1k5',R04,{'1':'VBUS','2':'USB_DM'})

notes=[(25.4,25.4,'POWER IN – USB-C 5V, TVS D3, PTC F1, ferrite FB1'),(119.38,25.4,'HV BOOST 75–100 V (MCU-controlled, TIM2_CH3 on PD6, 30 kHz)'),
 (25.4,96.52,'MCU CH32V003F4P6 (runs at 5 V)'),(25.4,100.33,'PD7 = SR_DATA: program NRST as GPIO (minichlink -D)'),(132.08,96.52,'INPUTS – LDR, TKEY touch pads, spare pad'),
 (25.4,177.8,'NEON LAMPS – Brightmaster NEON-3 (strike ≤90 VDC, ~60 V settled). Each lead: 150k (200 V type) to HV+ and one half of an MMDT5551 (160 V) to GND. Pull one lead low: that electrode glows.'),
 (25.4,181.61,'I_lamp = (V_HV - 60 V)/150k ≈ 0.1–0.3 mA, plus V_HV/150k ≈ 0.7 mA lost in the pulled-low lead\'s own pull-up. Both off: dark, no current.'),
 (180.34,137.16,'USB low-speed (rv003usb): D+ = PD2, D- = PD4.'),
 (180.34,140.97,'The MCU stays at 5 V: 68R + 3.6 V zeners clamp'),
 (180.34,144.78,'its drive to USB levels. 1k5 D- pull-up to VBUS.'),
 (228.6,96.52,'LAMP DRIVE – 2 × 74HC595: LAMPA1–10 (anode-side switches) + the cathode switches of LA1 and LA10'),
 (228.6,100.33,'SR_DATA = PD7, SR_CLK = PC7, SR_LATCH = PD5. /OE tied low: outputs are random until the first latch, but the boost is off then (R2).'),
 (119.38,81.28,'Q1 DMN15H310SE: 150 V, 0.33 Ω @ Vgs=5 V. R2 keeps boost off during reset.'),
 (119.38,85.09,'D2 = hard OVP clamp (Vbr 111–123 V). R12/C8 snubber: optional (DNP).')]

for ref,lib,name,*_ ,fp,nets,dnp,unit in parts:
    if fp and not ref.startswith('#'):
        l,f=fp.split(':'); assert os.path.exists((FPDIR if l!='NeonPine' else PRJ+'/')+f'{l}.pretty/{f}.kicad_mod'),fp
# ---- build
syms={}; out=[]; wires=[]; labels=[]; pwr=[]
def eff(hide=False,just=None):
    e=['effects',['font',['size','1.27','1.27']]]
    if just: e.append(['justify',just])
    if hide: e.append(['hide','yes'])
    return e
def prop(k,v,x,y,hide=False,just=None): return ['property',f'"{k}"',f'"{v}"',['at',f'{x:g}',f'{y:g}','0'],eff(hide,just)]
pinpos={}  # net -> list of (x,y,outdir)
npw=0
def place(ref,lib,name,x,y,val,fp,nets,dnp,unit=1,power=False,rot=0):
    lid=f'{lib}:{name}'
    if lid not in syms:
        s=copy.deepcopy(getsym(lib,name)); s[1]=f'"{lid}"'; syms[lid]=s
    s=syms[lid]
    sym=['symbol',['lib_id',f'"{lid}"'],['at',f'{x:g}',f'{y:g}',str(rot)],['unit',str(unit)],['exclude_from_sim','no'],
         ['in_bom','no' if power else 'yes'],['on_board','no' if power else 'yes'],['dnp','yes' if dnp else 'no'],['uuid',f'"{U()}"']]
    if power and rot in (90,270):   # sideways power symbol: value text horizontal, beyond its tip
        left=(rot==90)==(name!='GND')
        sym+= [prop('Reference',ref,x,y+3.81,True),['property','"Value"',f'"{val}"',['at',f'{x-5.08 if left else x+5.08:g}',f'{y:g}','90'],eff(False,'right' if left else 'left')]]
    elif power:
        sym+= [prop('Reference',ref,x,y+3.81,True),prop('Value',val,x,y-3.81 if name!='GND' else y+3.81)]
    elif ref in PROPS:
        rx,ry,vx,vy,j,a=PROPS[ref]; pr=lambda k,v,px,py: ['property',f'"{k}"',f'"{v}"',['at',f'{px:g}',f'{py:g}',str(a)],eff(False,j)]
        sym+= [pr('Reference',ref,rx,ry),pr('Value',val,vx,vy)]
    else:
        sym+= [prop('Reference',ref,x+5.08,y-1.27-(20.32 if ref=='U1' else 0),just='left'),prop('Value',val,x+5.08,y+1.27-(20.32 if ref=='U1' else 0),just='left')]
    sym+= [prop('Footprint',fp,x,y,True),prop('Datasheet','~',x,y,True),prop('Description','',x,y,True)]
    for no,nm,px,py,a in pins(getsym(lib,name),unit):
        sym.append(['pin',f'"{no}"',['uuid',f'"{U()}"']])
        if no in nets and ref not in MANUAL:
            import math
            d=(-round(math.cos(math.radians(a))),round(math.sin(math.radians(a))))
            pinpos.setdefault(nets[no],[]).append((round(x+px,2),round(y-py,2),d))
    sym.append(['instances',['project','"NeonPine"',['path',f'"/{ROOT}"',['reference',f'"{ref}"'],['unit',str(unit)]]]])
    out.append(sym)
for p in parts: place(*p,power=p[0].startswith('#'),rot=ROT.get(p[0],0))
def wire(a,b): wires.append(['wire',['pts',['xy',f'{a[0]:g}',f'{a[1]:g}'],['xy',f'{b[0]:g}',f'{b[1]:g}']],['stroke',['width','0'],['type','default']],['uuid',f'"{U()}"']])
for net,pl in pinpos.items():
    pl=list(dict.fromkeys(pl))
    if len(pl)==2 and pl[0][0]==pl[1][0] and net not in ('GND','+5V'):
        wire(pl[0][:2],pl[1][:2]); continue
    for x,y,d in pl:
        e=(round(x+d[0]*2.54,2),round(y+d[1]*2.54,2)); wire((x,y),e)
        if net in ('GND','+5V'):
            npw+=1
            if net=='GND': rot={(0,1):0,(0,-1):180,(1,0):90,(-1,0):270}[d]
            else: rot={(0,-1):0,(0,1):180,(-1,0):90,(1,0):270}[d]
            place(f'#PWR{npw:03d}','power',net,e[0],e[1],net,'',{},False,power=True,rot=rot)
        else:
            ang={(1,0):0,(-1,0):180,(0,-1):90,(0,1):270}[d]
            labels.append(['label',f'"{net}"',['at',f'{e[0]:g}',f'{e[1]:g}',str(ang)],['effects',['font',['size','1.27','1.27']],['justify','right' if ang in (180,270) else 'left','bottom']],['uuid',f'"{U()}"']])
for a,b in mw: wire(a,b)
junctions=[['junction',['at',f'{x:g}',f'{y:g}'],['diameter','0'],['color','0','0','0','0'],['uuid',f'"{U()}"']] for x,y in dict.fromkeys(mj)]
for net,x,y,ang in ml:
    labels.append(['label',f'"{net}"',['at',f'{x:g}',f'{y:g}',str(ang)],['effects',['font',['size','1.27','1.27']],['justify','right' if ang in (180,270) else 'left','bottom']],['uuid',f'"{U()}"']])
for net,x,y in mp:
    npw+=1; place(f'#PWR{npw:03d}','power',net,x,y,net,'',{},False,power=True)
ncs=[]
for ref in ('U2','U3','J1'):
    p=[q for q in parts if q[0]==ref][0]
    for no,nm,px,py,a in pins(getsym(p[1],p[2])):
        if no not in p[7]: ncs.append(['no_connect',['at',f'{p[3]+px:g}',f'{round(p[4]-py,2):g}'],['uuid',f'"{U()}"']])
texts=[['text',f'"{t}"',['exclude_from_sim','no'],['at',f'{x:g}',f'{y:g}','0'],['effects',['font',['size','2' if t.isupper() or '–' in t[:20] else '1.27','2' if t.isupper() or '–' in t[:20] else '1.27']],['justify','left','bottom']],['uuid',f'"{U()}"']] for x,y,t in notes]
sch=['kicad_sch',['version','20260306'],['generator','"eeschema"'],['generator_version','"10.0"'],['uuid',f'"{ROOT}"'],['paper','"A3"'],
     ['title_block',['title','"NeonPine – neon Christmas tree night light"'],['date','"2026-10-05"'],['rev','"B"']],
     ['lib_symbols']+list(syms.values())]+texts+junctions+ncs+wires+labels+out+[['sheet_instances',['path','"/"',['page','"1"']]],['embedded_fonts','no']]
open(os.path.join(PRJ,'NeonPine.kicad_sch'),'w').write(dump(sch)+'\n')
print(len(parts),'parts', npw,'pwr', len(labels),'labels')
